lukewalker2010/mach1-rc-design/proposals/geometry/README.md

# Analytic geometry candidate — not manufacturing data

See [29](../../29_geometry_resolution.md) for formulas, source provenance,
numerical results, demonstrated packaging failures and unresolved interfaces.
`tools/geometry_candidates.py` is the candidate source; export functions can
produce review station CSVs. No generated net parts or qualified CAD are supplied.
Any future exports belong here and require review before promotion to baseline.
