lukewalker2010/mach1-rc-design/proposals/geometry/fuselage_stations_v3.csv

x_mm | R_mm | OD_mm
0 | 0.0 | 0.0
50 | 0.9226 | 1.8451
100 | 3.5396 | 7.0792
150 | 7.6252 | 15.2504
200 | 12.9534 | 25.9068
250 | 19.2983 | 38.5966
300 | 26.434 | 52.8679
350 | 34.1344 | 68.2689
400 | 42.1738 | 84.3476
450 | 50.3262 | 100.6524
500 | 58.3656 | 116.7311
550 | 66.066 | 132.1321
600 | 73.2017 | 146.4034
650 | 79.5466 | 159.0932
700 | 84.8748 | 169.7496
750 | 88.9604 | 177.9208
800 | 91.5774 | 183.1549
850 | 92.5 | 185.0
900 | 91.4844 | 182.9687
950 | 89.25 | 178.5
1000 | 87.0156 | 174.0312
1050 | 86.0 | 172.0
1100 | 86.3804 | 172.7607
1150 | 87.3561 | 174.7122
1200 | 88.6791 | 177.3582
1250 | 90.1014 | 180.2027
1300 | 91.3748 | 182.7495
1350 | 92.2513 | 184.5025
1400 | 92.5 | 185.0
1450 | 92.5 | 185.0
1500 | 92.5 | 185.0
1550 | 92.5 | 185.0
1600 | 92.5 | 185.0
1650 | 92.5 | 185.0
1700 | 92.5 | 185.0
1750 | 92.5 | 185.0
1800 | 92.5 | 185.0
1850 | 92.0789 | 184.1577
1900 | 90.8887 | 181.7773
1950 | 89.0393 | 178.0786
2000 | 86.6406 | 173.2812
2050 | 83.8025 | 167.605
2100 | 80.6348 | 161.2695
2150 | 77.2473 | 154.4946
2200 | 73.75 | 147.5
2250 | 70.2527 | 140.5054
2300 | 66.8652 | 133.7305
2350 | 63.6975 | 127.395
2400 | 60.8594 | 121.7188
2450 | 58.4607 | 116.9214
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
