lukewalker2010/mach1-rc-design/proposals/structure/wing_box_spar/stations.csv

station | y_m | chord_mm | moment_nm | shear_n | cap_thickness_mm | web_area_mm2 | web_shear_mpa | width_mm | cap_area_mm2 | separation_mm | outer_depth_mm | inner_height_mm | box_le_mm | box_te_mm | u_lo | u_hi
C0 | 0.0 | 210.52631578947373 | 150.0 | 736.8421052631566 | 1.0 | 7.830062067438473 | 94.104248333782 | 76.29656810450128 | 76.29656810450128 | 4.915031033719236 | 7.315031033719237 | 3.9150310337192367 | 67.11487384248622 | 143.4114419469875 | 0.3187956507518095 | 0.6812043492481905
R0 | 0.092625 | 185.89473684210532 | 90.88550624999995 | 543.5868421052621 | 0.883 | 7.084457140130598 | 76.72949830214392 | 58.14846144027421 | 51.34509145176213 | 4.4252285700653 | 6.708228570065299 | 3.542228570065299 | 63.87313770091555 | 122.02159914118977 | 0.34359841911591027 | 0.6564015808840897
R1 | 0.16902083333333334 | 165.5789473684211 | 54.859939728009174 | 402.2651315789467 | 0.7865 | 6.3684917830342425 | 63.1648976372376 | 43.916175567618026 | 34.54007208393158 | 3.9707458915171205 | 6.157245891517121 | 3.1842458915171212 | 60.831385900401536 | 104.74756146801957 | 0.3673859924054764 | 0.6326140075945236
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
