lukewalker2010/mach1-rc-design/09_bom.md

# Bill of Materials and Build Sequence

> **Historical:** the current aircraft allowance is `22_bom_v2.md`; this legacy
> BOM is retained for design history and is not a purchase list.

## 1. Bill of Materials

### 1.1 Major Components

| Item | Supplier / Part | Qty | Unit Cost | Total |
|---|---|-----|---|---|
| **Engine** | JetCat P550-PRO (incl. ECU + pump) | 1 | $4,500.00 | $4,500.00 |
| **Carbon fiber prepreg** | ACP Composites 3K twill 200 g/m² | 5 m² | $45.00/m² | $225.00 |
| **Carbon unidirectional (spar)** | DragonPlate 5 mm pultruded rod | 1 m | $18.00/m | $18.00 |
| **Epoxy resin (wet layup)** | West System 105 resin + 206 hardener | 2 L | $60.00/L | $120.00 |
| **Epoxy bonding / filleting** | West System 105 + 406 colloidal silica (flox) | 0.5 L | $40.00 | $40.00 |
| **Foam core (wing)** | Rohacell 71IG, 5 mm thick | 1 m² | $80.00/m² | $80.00 |
| **Inconel 718 (intake)** | Xometry DMLS (or similar additive mfg) | 1 | ~$350.00 | $350.00 |
| **304 stainless steel tube (nozzle)** | McMaster-Carr, 35 mm OD × 1 mm wall | 50 mm | $10.00 | $10.00 |
| **7075-T6 aluminum plate** | McMaster-Carr (mount ring, hardpoints) | 0.2 m² | $50.00 | $50.00 |
| **6061-T6 aluminum sheet** | McMaster-Carr (brackets, small parts) | 0.3 m² | $20.00 | $20.00 |

### 1.2 Avionics

| Item | Supplier / Part | Qty | Unit Cost | Total |
|---|---|-----|---|---|
| **RC receiver** | Futaba R7018SB (18-channel) | 1 | $350.00 | $350.00 |
| **Flight controller** | Cube Orange+ (Pixhawk) | 1 | $300.00 | $300.00 |
| **GPS module** | Here+ GNSS (or similar) | 1 | $100.00 | $100.00 |
| **Telemetry radio** | RFD900x (900 MHz) | 1 | $120.00 | $120.00 |
| **Pitot-static system** | Eagle Tree pitot + static ports | 1 | $45.00 | $45.00 |
| **Airspeed sensor** | MS4525DO differential pressure | 1 | $35.00 | $35.00 |

### 1.3 Power System

| Item | Supplier / Part | Qty | Unit Cost | Total |
|---|---|-----|---|---|
| **Battery** | 2S LiPo 5000 mAh 30C | 1 | $80.00 | $80.00 |
| **Power distribution board** | Custom PCB or Pre-built (Pixhawk Power Module) | 1 | $25.00 | $25.00 |
| **Connectors — Deans Ultra** | Amass T-plug (male + female pairs) | 3 | $4.00 | $12.00 |
| **Connectors — JR** | JR servo connectors (male + female) | 20 | $1.50 | $30.00 |
| **Wire — 14 AWG silicone** | Red/Black, per meter | 3 m | $5.00/m | $15.00 |
| **Wire — 20 AWG silicone** | Assorted colors, per meter | 5 m | $3.00/m | $15.00 |
| **Wire — 22 AWG silicone** | Signal wire, per meter | 10 m | $2.50/m | $25.00 |
| **Conduit — braided nylon** | 10 mm diameter | 3 m | $4.00/m | $12.00 |

### 1.4 Fuel System

| Item | Supplier / Part | Qty | Unit Cost | Total |
|---|---|-----|---|---|
| **Fuel bladder (custom)** | Polyurethane 2-ply, 1.5 L | 1 | $50.00 | $50.00 |
| **Viton tubing** | 4 mm ID × 7 mm OD | 3 m | $15.00/m | $45.00 |
| **Viton tubing (vent)** | 2 mm ID × 4 mm OD | 1 m | $10.00/m | $10.00 |
| **Fuel dot** | Dubro 6 mm (HD-175) | 1 | $8.00 | $8.00 |
| **Check valve** | One-way fuel vent valve | 1 | $12.00 | $12.00 |
| **Fuel filter** | Felt clunk filter (large) | 1 | $6.00 | $6.00 |
| **Brass fittings** | Assorted barbs, tees, elbows | 1 lot | $15.00 | $15.00 |

### 1.5 Control System

| Item | Supplier / Part | Qty | Unit Cost | Total |
|---|---|-----|---|---|
| **Servo — KST X20-12T** | High-voltage, 12 kg·cm titanium gear | 2 | $120.00 | $240.00 |
| **Pushrod** | 2 mm titanium rod, threaded ends | 2 | $5.00 | $10.00 |
| **Ball links** | Dubro 4-40 (or M2.5) with hardware | 4 | $4.00 | $16.00 |
| **Servo extension wires** | 300 mm JR-type | 4 | $4.00 | $16.00 |
| **Servo mounting screws** | M2.5 × 6 mm stainless | 8 | $0.50 | $4.00 |

### 1.6 Landing and Launch

| Item | Supplier / Part | Qty | Unit Cost | Total |
|---|---|-----|---|---|
| **UHMWPE strip** | 50 mm × 200 mm × 5 mm | 2 | $8.00 | $16.00 |
| **Titanium sheet (skid shoe)** | Ti-6Al-4V, 1 mm × 50 mm × 200 mm | 2 | $15.00 | $30.00 |
| **Dolly wheel — polyurethane** | 50 mm dia × 20 mm wide (custom) | 2 | $12.00 | $24.00 |
| **Dolly frame extrusion** | 2024-T6 T-slot, 20 × 20 mm | 2 m | $12.00/m | $24.00 |
| **Dolly hardware** | Axles, bearings, E-clips, fasteners | 1 lot | $15.00 | $15.00 |
| **Dolly latch servo** | 5 g micro servo (metal gear) | 1 | $12.00 | $12.00 |
| **Separation spring** | Compression, 50 N, 30 mm stroke | 1 | $5.00 | $5.00 |
| **Dolly parachute (optional)** | 0.3 m ripstop nylon | 1 | $10.00 | $10.00 |

### 1.7 Drogue Chute

| Item | Supplier / Part | Qty | Unit Cost | Total |
|---|---|-----|---|---|
| **Main chute** | 0.6 m hemispherical ribbon, ripstop nylon | 1 | $30.00 | $30.00 |
| **Pilot chute** | 0.1 m spring-loaded | 1 | $15.00 | $15.00 |
| **Bridle line** | 500 kg Kevlar, 3 m | 1 | $10.00 | $10.00 |
| **Swivel** | Ball-bearing swivel | 1 | $8.00 | $8.00 |
| **Container (G10 box)** | Custom fiberglass/ G10 | 1 | $20.00 | $20.00 |
| **Weak link / jettison** | Kevlar thread 100 kg + hook | 1 | $12.00 | $12.00 |

### 1.8 Tooling and Consumables

| Item | Supplier / Part | Qty | Unit Cost | Total |
|---|---|-----|---|---|
| **Mold release** | Partall #2 or similar | 1 L | $25.00 | $25.00 |
| **Peel ply** | Nylon peel ply (1 m wide) | 5 m | $8.00/m | $40.00 |
| **Breather fabric** | Polyester breather (1 m wide) | 5 m | $6.00/m | $30.00 |
| **Vacuum bag film** | Nylon bag film (1 m wide) | 5 m | $10.00/m | $50.00 |
| **Bag sealant tape** | QT-2 butyl sealant tape | 2 rolls | $6.00 | $12.00 |
| **CNC foam (plug)** | Polyurethane foam block, 200×200×1000mm | 1 | $30.00 | $30.00 |
| **Sanding supplies** | Grits 80–1000, sanding blocks | 1 lot | $25.00 | $25.00 |
| **Vacuum pump** | Robinair 2-stage (rental or shop) | 1 use | $50.00 | $50.00 |
| **CFC / tooling gelcoat** | Tooling gelcoat (grey) | 2 kg | $30.00/kg | $60.00 |
| **Fiberglass (tooling)** | 200 g/m² woven, for splash mold | 10 m² | $10.00/m² | $100.00 |
| **Fasteners assortment** | M2, M2.5, M3, M4, M6 nylon + stainless | 1 lot | $30.00 | $30.00 |

### 1.9 Summary

| Category | Cost |
|---|---|
| Major structure & engine | $5,413.00 |
| Avionics | $950.00 |
| Power system | $174.00 |
| Fuel system | $146.00 |
| Control system | $286.00 |
| Landing & launch | $136.00 |
| Drogue chute | $95.00 |
| Tooling & consumables | $462.00 |
| **Total** | **~$7,662.00** |

> **Note:** Rounding to **~$7,000–7,700** depending on discounts / sourcing. Prices as of 2026.

---

## 2. Build Sequence

### Phase 1 — Tooling (40 hours estimated)

| Step | Task | Hours | Details |
|---|---|---|---|
| 1.1 | CNC mill fuselage plug from station table | 20 | PU foam block machined to fuselage station templates, sanded smooth |
| 1.2 | Splash mold from plug | 15 | Apply tooling gelcoat, 10 layers 200 g/m² fiberglass, cure, separate |
| 1.3 | CNC mill wing mold (female) | 5 | Two-cavity mold for upper and lower wing skins |
| **Phase 1 total** | | **40** | |

### Phase 2 — Structure (60 hours estimated)

| Step | Task | Hours | Details |
|---|---|---|---|
| 2.1 | Lay up fuselage halves | 10 | Hand layup of prepreg carbon in mold, vacuum bag, oven cure (120°C) |
| 2.2 | Trim and bond fuselage halves | 4 | Diamond cut off wheel, structural epoxy + 50 mm carbon doubler strips |
| 2.3 | Install bulkheads BH1–BH8 | 8 | Precision locate from station table, bond with flox structural fillets |
| 2.4 | Fabricate wing skins | 6 | Layup in mold, 4 layers 200 g/m² prepreg, vacuum bag, cure |
| 2.5 | Machine wing spar groove in foam core | 4 | CNC router pocket for 5 mm carbon rod, test fit |
| 2.6 | Insert spar + assemble wing | 2 | Bond carbon rod with structural epoxy, fit to foam core |
| 2.7 | Wing skin bonding | 8 | Bond upper and lower skins to foam core + spar, vacuum bag, cure |
| 2.8 | Trim wing to final shape | 2 | Diamond wheel, profile to airfoil template |
| 2.9 | Fabricate stabilator | 4 | Solid carbon laminate layup, cure, profile to NACA 64A-xxx, |
| 2.10 | Bond waist doubler + hardpoints | 4 | Internal doubler strips at wing root, M4 threaded inserts |
| 2.11 | Install engine mount ring and legs | 4 | 7075-T6 ring bonded to BH5/BH6, 3 legs with screws to engine |
| 2.12 | Bond belly skid brackets | 2 | 2 mm Al brackets to fuselage hardpoints |
| 2.13 | Install drogue chute container | 2 | G10 box bonded into tailcone, door hinged and fit-checked |
| **Phase 2 total** | | **60** | |

### Phase 3 — Systems Installation (30 hours estimated)

| Step | Task | Hours | Details |
|---|---|---|---|
| 3.1 | Install fuel bladder + plumbing | 4 | Position bladder in forward bay, route Viton lines, install clunk and fittings |
| 3.2 | Install vent line + check valve | 1 | Route 2 mm line from tank to bottom of fuselage |
| 3.3 | Install fuel dot (filler) | 0.5 | Flush mount on fuselage side at x = 0.50 m |
| 3.4 | Install servos + pushrods | 4 | Mount KST X20-12T in wing (elevon?), 2 mm Ti pushrods, ball links |
| 3.5 | Install avionics tray + flight controller | 4 | TPU vibration mount, Cube Orange, receiver, secure with nylon screws |
| 3.6 | Install GPS + pitot-static system | 2 | GPS on fuselage top, pitot probe on nose, static ports on sides |
| 3.7 | Install telemetry module + antenna | 1 | RFD900x in dorsal fairing, whip antenna |
| 3.8 | Run wiring + install connectors | 8 | Shielded conduits along fuse sides, power starboard, signal port, continuity test |
| 3.9 | Install engine + intake + nozzle | 4 | Mount P550-PRO on ring, fit intake duct, nozzle, secure ECU |
| 3.10 | CG check + ballast adjustment | 2 | Weigh aircraft at 3 points, compare to CG table, add tungsten ballast as needed |
| 3.11 | Install drogue chute system | 2 | Pack main + pilot chute, install bridle + weak link, test door servo |
| 3.12 | Install belly skid strips | 1 | Bolt UHMWPE strips to Ti shoes, bolt shoes to brackets |
| 3.13 | Final systems integration test | 2 | Power on, servo range check, FC calibration, ECU communication |
| **Phase 3 total** | | **30** | |

### Phase 4 — Testing and Flight (20 hours estimated)

| Step | Task | Hours | Details |
|---|---|---|---|
| 4.1 | Engine ground run with intake | 2 | Secure aircraft, run engine to idle, check EGT/TIT, spool to full, verify stable |
| 4.2 | Range check + failsafe setup | 2 | Walk 100 m with transmitter, failsafe: throttle idle, full-up elevon |
| 4.3 | Control surface check | 1 | Full deflection measure, direction verify, rate check |
| 4.4 | High-speed taxi test on dolly | 2 | Attach dolly, taxi to 30 m/s, verify tracking, steering, dolly retention |
| 4.5 | Flight 1 — Low-speed handling (M0.2) | 3 | Launch, trim at ~70 m/s, basic handling, land with drogue |
| 4.6 | Flight 2 — Envelope expansion (M0.5) | 3 | Increase speed to ~170 m/s, check stability, pitch response |
| 4.7 | Flight 3 — High-speed check (M0.7) | 3 | ~240 m/s, verify controls at high dynamic pressure |
| 4.8 | Flight 4 — Transonic attempt (M0.9→M1+) | 4 | Full throttle run, Mach target 0.95–1.05, record with GPS + Doppler |
| **Phase 4 total** | | **20** | |

### Build Timeline Summary

| Phase | Hours | % of Total |
|---|---|---|
| Phase 1 — Tooling | 40 | 27% |
| Phase 2 — Structure | 60 | 40% |
| Phase 3 — Systems | 30 | 20% |
| Phase 4 — Testing | 20 | 13% |
| **Total** | **150** | **100%** |

---

## 3. Safety Equipment Checklist

- [ ] **Fire extinguisher** — CO₂, 5 lb, at flight line (within 10 m of pit area)
- [ ] **Nomex flight gloves** — Required for engine starting and handling hot sections
- [ ] **Hearing protection** — 30+ dB NRR ear muffs (turbine = 120+ dB at close range)
- [ ] **Eye protection** — Safety glasses (impact rated, Z87+)
- [ ] **First aid kit** — At pit area
- [ ] **Fuel container** — Approved, grounded Jet-A1 container with spout
- [ ] **Fuel spill kit** — Absorbent pads, gloves, disposal bag
- [ ] **Fire blanket** — For engine fire containment
- [ ] **Grounding strap** — For fueling operation (static discharge prevention)
- [ ] **FAA COA or restricted airspace clearance** — Required for any high-speed / record flight
- [ ] **Insurance** — AMA membership + supplemental turbine waiver insurance
- [ ] **Doppler radar** — For speed verification (or certified GPS-logger for record)

---

## 4. Flight Day Checklist

### 4.1 Pre-Flight (2 hours prior)
- [ ] Weather check: wind < 10 kt, visibility > 5 km, no precipitation
- [ ] Airspace clearance confirmed (COA active, NOTAM issued if required)
- [ ] Flight area marked and spectator exclusion zone set (min 100 m radius)
- [ ] All safety equipment on-site (fire extinguisher, first aid, Nomex gloves)

### 4.2 Aircraft Preparation (1 hour prior)
- [ ] **Structural inspection:** All bond lines (fuselage seam, wing root, stabilator), no cracks or delamination
- [ ] **Fastener check:** All screws and bolts present and tight (M2 through M4)
- [ ] **Control surface:** Full deflection check — elevons, rudder if present — direction and range
- [ ] **Pushrod / ball link:** No slop, secure clevis retainers
- [ ] **Fuel system:** Tank full (1.5 L Jet A-1), no leaks, clunk free, vent clear
- [ ] **Battery:** 2S LiPo at storage voltage (7.6–7.8 V), charge if needed to 8.2 V
- [ ] **Telemetry / GPS:** Power on, satellite lock (min 10 sats), HDOP < 1.0
- [ ] **Receiver range check:** Reduced power mode, 100 m walk, no frame loss

### 4.3 Engine Start (30 min prior)
- [ ] **Fire extinguisher** positioned near tail, operator wearing Nomex gloves
- [ ] **ECU startup:** Connect ECU to computer (JetCat USB), verify firmware, parameters
- [ ] **Fuel prime:** Prime fuel line (pump in manual mode until fuel reaches engine)
- [ ] **Start:** Command start, monitor EGT/TIT (max 850°C on start)
- [ ] **Idle check:** 2 min at idle (60,000 RPM typical), verify stable EGT
- [ ] **Full-throttle run (5 s):** Spool to full (165,000 RPM), verify RPM, EGT, fuel flow
- [ ] **Return to idle:** Check idle stability after full-throttle

### 4.4 Launch Preparation (15 min prior)
- [ ] **Dolly attachment:** Place dolly under fuselage, engage latch pins, verify positive lock
- [ ] **Dolly release test:** On ground, cycle release servo, confirm clean separation
- [ ] **Drogue chute armed:** Door servo connected, safeties removed
- [ ] **Flight path clear:** Visual scan of airspace, observers in position
- [ ] **Go/no-go decision:** Wind, visibility, aircraft readiness, pilot readiness
- [ ] **Final control check:** Full deflection observed from behind aircraft

### 4.5 Launch Sequence
1. **Pilot:** "Cleared for takeoff" — advance throttle to full
2. Acceleration monitored by telemetry (GPS groundspeed)
3. At V_r ≈ 70 m/s (or positive pitch command from FC)
4. Dolly latch release (pitch-up detected by FC or Rx switch)
5. Clean separation confirmed visually
6. **Pilot:** "Positive rate, gear up" (dolly released)
7. Climb at 70 m/s to safe altitude (100 m AGL minimum)

### 4.6 In-Flight
- [ ] Trim aircraft at cruise speed (M0.2 for first flights)
- [ ] Monitor EGT, RPM, fuel level via telemetry
- [ ] Note any handling quirks (pitch sensitivity, roll rate, coupling)

### 4.7 Landing
- [ ] Throttle to idle, deploy drogue chute (if >15 m/s final)
- [ ] Belly skid contact, hold attitude until stop
- [ ] **Post-landing:** Engine shutdown (ECU spool-down cycle)
- [ ] Fuel remaining measurement, CG check for excursion data

### 4.8 Post-Flight
- [ ] Skid wear inspection, replace strips if worn below 2 mm
- [ ] Drogue chute repack (if deployed)
- [ ] Dolly inspection (if recovered), repair any damage
- [ ] Data download: GPS track, FC logs, ECU data
- [ ] Battery recharge (LiPo storage voltage)
- [ ] Debrief: handling notes, adjustments for next flight
