lukewalker2010/mach1-rc-design/09_bom_with_links.md

# Mach 1 RC Aircraft — Complete Bill of Materials with Purchase Links

> **Historical (2026-07-21):** retained for source/link history. The current
> aircraft allowance is `22_bom_v2.md`; flagged parts there remain
> unpurchase-qualified.

**Updated:** 2026-07-21
**Total Budget:** ~$7,700

---

## 1. Engine & Powerplant

| Item | Part | Qty | Price | Purchase Link | Notes |
|---|---|-----|---|---|---|
| **Engine** | JetCat P550-PRO (incl. ECU + pump) | 1 | $4,500 | [jetcat.de](https://www.jetcat.de/en/products/produkte/jetcat/kategorien/professional/550%20PRO-S) · [Chief RC](https://www.chiefrc.com/collections/jet-cat-turbines) | Price on request from JetCat. US dealers ~$4,500-5,500 |

## 2. Major Structure Materials

| Item | Part | Qty | Price | Purchase Link | Notes |
|---|---|-----|---|---|---|
| **Carbon prepreg** | ACP Composites 3K twill 200 g/m² | 5 m² | $225 | [ACP Composites — Carbon Prepregs](https://acpcomposites.com/category/carbon-fiber/carbon-prepregs) | |
| **Carbon spar rod** | DragonPlate 5mm pultruded T800 | 1m | $18 | [DragonPlate — Carbon Fiber Rods](https://dragonplate.com/carbon-fiber-rod) | |
| **Epoxy resin** | West System 105 + 206 hardener | 2L | $120 | [West System](https://www.westsystem.com) · [Amazon](https://www.amazon.com/s?k=west+system+105+206) | |
| **Epoxy bonding** | West System 105 + 406 colloidal silica | 0.5L | $40 | [West System](https://www.westsystem.com) | |
| **Foam core** | Rohacell 71IG, 5mm | 1 m² | $80 | [Aircraft Spruce](https://www.aircraftspruce.com) | |
| **Inconel 718 intake** | Xometry DMLS 3D print | 1 | $350 | [Xometry — Instant Quote](https://www.xometry.com) | Upload STL, get instant quote |
| **SS tube (nozzle)** | 304 SS, 35mm OD × 1mm wall | 50mm | $10 | [mcmaster.com](https://www.mcmaster.com/304-stainless-steel-tubing) | P/N 89525K514 |
| **7075-T6 plate** | Mount ring, hardpoints | 0.2m² | $50 | [mcmaster.com](https://www.mcmaster.com/7075-aluminum) | |
| **6061-T6 sheet** | Brackets, small parts | 0.3m² | $20 | [mcmaster.com](https://www.mcmaster.com/6061-aluminum) | |

## 3. Avionics

| Item | Part | Qty | Price | Purchase Link | Notes |
|---|---|-----|---|---|---|
| **RC Receiver** | Futaba R7018SB (18-ch FASSTest) | 1 | $329 | [eBay](https://www.ebay.com/sch/i.html?_nkw=Futaba+R7018SB) · [HobbyKing](https://hobbyking.com/en_us/futaba-r7018sb-s-bus-2-18ch-fasstest-telemetry-receiver.html) · [Modelland](https://store.modelland.com/p-110546-futaba-futr7018sb-r7018sb-2-4ghz-fasstest-receiver-dual-battery.aspx) | Check stock — often sold out |
| **Flight Controller** | Cube Orange+ Standard Set (w/ ADS-B) | 1 | $300 | [Amazon](https://www.amazon.com/The-Cube-Orange-Standard-Set/dp/B0C8Y1LMGZ) · [ReadyMadeRC](https://www.readymaderc.com/products/details/pixhawk2-cube-orange-plus-standard-set-cube-carrier) · [CubePilot](https://www.cubepilot.com) | |
| **GPS** | CubePilot Here+ RTK GNSS (M8P) | 1 | $100 | [CubePilot](https://www.cubepilot.com) · [GetFPV](https://www.getfpv.com/cubepilot-here-rtk-gnss-gps-kit-m8p.html) · [RobotShop](https://www.robotshop.com/products/cubepilot-here-v2-rtk-gnss-gps-m8p) | |
| **Telemetry** | RFD900x-US (FCC approved) | 1 | $120 | [ReadyMadeRC](https://www.readymaderc.com/products/details/rfdesign-rfd-900x-modem-us-fcc) · [RFD900x Bundle](https://www.readymaderc.com/products/details/rfdesign-900x-telemetry-modem-bundle) · [WorldDroneMarket](https://www.worldronemarket.com/product/rfd900x-us-bundle/) | Buy bundle (air + ground) for ~$220 |
| **Pitot-static** | Eagle Tree pitot + static ports | 1 | $45 | [ReadyMadeRC — Eagle Tree Pitot Kit](https://www.readymaderc.com/products/details/eagle-tree-additional-prandtl-pitot-static-tube-kit) | |
| **Airspeed sensor** | MS4525DO differential pressure | 1 | $35 | [Mouser](https://www.mouser.com/Search/Refine?Keyword=MS4525DO) · [DigiKey](https://www.digikey.com/en/products/filter/pressure-sensors/534) · [eBay](https://www.ebay.com/sch/i.html?_nkw=MS4525DO) | |

## 4. Power System

| Item | Part | Qty | Price | Purchase Link | Notes |
|---|---|-----|---|---|---|
| **Battery** | 2S LiPo 5000mAh 30C | 1 | $80 | [Amazon](https://www.amazon.com/s?k=2S+LiPo+5000mAh+30C) · [HobbyKing](https://hobbyking.com) · [AMain Hobbies](https://www.amainhobbies.com) | Deans connector preferred |
| **Power dist** | Pixhawk Power Module | 1 | $25 | [CubePilot](https://www.cubepilot.com) · [Amazon](https://www.amazon.com/s?k=pixhawk+power+module) | |
| **Deans connectors** | Amass T-plug pairs | 3 | $12 | [Amazon](https://www.amazon.com/s?k=amass+deans+t-plug) | |
| **JR connectors** | Male + female servo connectors | 20 | $30 | [Amazon](https://www.amazon.com/s?k=jr+servo+connector) | |
| **Wire 14AWG** | Silicone, red/black | 3m | $15 | [Amazon](https://www.amazon.com/s?k=14+awg+silicone+wire) | |
| **Wire 20AWG** | Silicone, assorted | 5m | $15 | [Amazon](https://www.amazon.com/s?k=20+awg+silicone+wire) | |
| **Wire 22AWG** | Silicone, signal | 10m | $25 | [Amazon](https://www.amazon.com/s?k=22+awg+silicone+wire) | |
| **Conduit** | Braided nylon, 10mm | 3m | $12 | [Amazon](https://www.amazon.com/s?k=braided+nylon+cable+sleeve+10mm) | |

## 5. Fuel System

| Item | Part | Qty | Price | Purchase Link | Notes |
|---|---|-----|---|---|---|
| **Fuel bladder** | Polyurethane 2-ply, 1.5L custom | 1 | $50 | Custom — [McMaster](https://www.mcmaster.com) polyurethane sheet | Or contact JetCat for OEM tank |
| **Viton tubing** | 4mm ID × 7mm OD | 3m | $45 | [McMaster](https://www.mcmaster.com/viton-tubing) · [Amazon](https://www.amazon.com/s?k=viton+tubing+4mm) | |
| **Viton vent** | 2mm ID × 4mm OD | 1m | $10 | [McMaster](https://www.mcmaster.com) | |
| **Fuel dot** | Dubro HD-175 (6mm) | 1 | $8 | [Amazon](https://www.amazon.com/s?k=dubro+fuel+dot) · [Tower Hobbies](https://www.towerhobbies.com) | |
| **Check valve** | One-way fuel vent | 1 | $12 | [Amazon](https://www.amazon.com/s?k=fuel+check+valve+rc) | |
| **Clunk filter** | Felt filter, large | 1 | $6 | [Amazon](https://www.amazon.com/s?k=rc+fuel+clunk+filter) | |
| **Brass fittings** | Barbs, tees, elbows | 1 lot | $15 | [Amazon](https://www.amazon.com/s?k=brass+barb+fittings+rc) | |

## 6. Control System

| Item | Part | Qty | Price | Purchase Link | Notes |
|---|---|-----|---|---|---|
| **Servos** | KST X20-12T (12kg HV titanium) | 2 | $240 | [KST Official](https://kstservos.com/collections/x20-series-1) ($120ea) · [Buddy RC](https://www.buddyrc.com/collections/kst-servos) · [eBay](https://www.ebay.com/sch/i.html?_nkw=KST+X20-12T) | Check stock — popular servo |
| **Pushrods** | 2mm Ti rod, threaded ends | 2 | $10 | [Amazon](https://www.amazon.com/s?k=2mm+titanium+rod+threaded) | |
| **Ball links** | Dubro 4-40 / M2.5 | 4 | $16 | [Amazon](https://www.amazon.com/s?k=dubro+ball+link) | |
| **Servo extensions** | 300mm JR-type | 4 | $16 | [Amazon](https://www.amazon.com/s?k=servo+extension+300mm+jr) | |
| **Servo screws** | M2.5 × 6mm stainless | 8 | $4 | [Amazon](https://www.amazon.com/s?k=M2.5+stainless+screws) | |

## 7. Landing & Launch

| Item | Part | Qty | Price | Purchase Link | Notes |
|---|---|-----|---|---|---|
| **UHMWPE strip** | 50mm × 200mm × 5mm | 2 | $16 | [Amazon](https://www.amazon.com/s?k=uhmwpe+sheet) · [McMaster](https://www.mcmaster.com/uhmw) | |
| **Ti skid shoe** | Ti-6Al-4V, 1mm × 50mm × 200mm | 2 | $30 | [eBay](https://www.ebay.com/sch/i.html?_nkw=titanium+sheet+6al4v) | |
| **Dolly wheels** | 50mm PU, 20mm wide | 2 | $24 | [Amazon](https://www.amazon.com/s?k=50mm+polyurethane+wheel) | |
| **Dolly frame** | 2024-T6 T-slot 20×20mm | 2m | $24 | [McMaster](https://www.mcmaster.com/t-slot-framing) | |
| **Dolly hardware** | Axles, bearings, E-clips | 1 lot | $15 | [Amazon](https://www.amazon.com/s?k=mini+bearing+axle+kit) | |
| **Release servo** | 5g micro servo, metal gear | 1 | $12 | [Amazon](https://www.amazon.com/s?k=5g+micro+servo+metal+gear) | |
| **Separation spring** | 50N compression, 30mm stroke | 1 | $5 | [McMaster](https://www.mcmaster.com/springs) | |
| **Dolly parachute** | 0.3m ripstop nylon | 1 | $10 | [Amazon](https://www.amazon.com/s?k=ripstop+nylon+mini+parachute) | |

## 8. Drogue Chute

| Item | Part | Qty | Price | Purchase Link | Notes |
|---|---|-----|---|---|---|
| **Main chute** | 0.6m hemispherical ribbon | 1 | $30 | [ChutingStar](https://www.chutingstar.com) · [Amazon](https://www.amazon.com/s?k=0.6m+drogue+parachute) | |
| **Pilot chute** | 0.1m spring-loaded | 1 | $15 | [Amazon](https://www.amazon.com/s?k=rc+pilot+chute+spring) | |
| **Bridle** | 500kg Kevlar, 3m | 1 | $10 | [Amazon](https://www.amazon.com/s?k=kevlar+cord+500kg) | |
| **Swivel** | Ball-bearing swivel | 1 | $8 | [Amazon](https://www.amazon.com/s?k=ball+bearing+swivel+parachute) | |
| **Container** | G10 box, custom | 1 | $20 | Fabricate from G10 sheet | |
| **Weak link** | Kevlar thread 100kg + hook | 1 | $12 | [Amazon](https://www.amazon.com/s?k=kevlar+thread+parachute) | |

## 9. Tooling & Consumables

| Item | Part | Qty | Price | Purchase Link | Notes |
|---|---|-----|---|---|---|
| **Mold release** | Partall #2 paste wax | 1L | $25 | [Amazon](https://www.amazon.com/s?k=partall+2+mold+release) | |
| **Peel ply** | Nylon, 1m wide | 5m | $40 | [Amazon](https://www.amazon.com/s?k=peel+ply+nylon+composite) | |
| **Breather cloth** | Polyester, 1m wide | 5m | $30 | [Amazon](https://www.amazon.com/s?k=vacuum+bagging+breather+cloth) | |
| **Vacuum bag** | Nylon film, 1m wide | 5m | $50 | [Amazon](https://www.amazon.com/s?k=vacuum+bag+film+nylon) | |
| **Bag sealant** | QT-2 butyl tape | 2 rolls | $12 | [Amazon](https://www.amazon.com/s?k=vacuum+bag+sealant+tape) | |
| **CNC foam plug** | PU foam block 200×200×1000mm | 1 | $30 | [McMaster](https://www.mcmaster.com/urethane-foam) | |
| **Sanding** | Grits 80-1000, blocks | 1 lot | $25 | [Amazon](https://www.amazon.com/s?k=sandpaper+assortment+80+1000) | |
| **Tooling gelcoat** | Grey, 2kg | 2kg | $60 | [Fibre Glast](https://www.fibreglast.com) · [Amazon](https://www.amazon.com/s?k=tooling+gelcoat) | |
| **Fiberglass** | 200 g/m² woven, tooling | 10 m² | $100 | [Fibre Glast](https://www.fibreglast.com) · [Amazon](https://www.amazon.com/s?k=fiberglass+cloth+200g) | |
| **Fasteners** | M2-M6 nylon + stainless | 1 lot | $30 | [Amazon](https://www.amazon.com/s?k=model+aircraft+hardware+kit) | |

---

## Budget Summary

| Category | Estimated Cost |
|---|---|
| Engine & powerplant | $4,500 |
| Structure materials | $923 |
| Avionics | $929 |
| Power system | $224 |
| Fuel system | $146 |
| Control system | $286 |
| Landing & launch | $136 |
| Drogue chute | $95 |
| Tooling & consumables | $427 |
| **Total** | **~$7,666** |

---

## Quick Buy Checklist

### Priority 1 — Order Now (long lead times)
- [ ] JetCat P550-PRO — contact [jetcat.de](https://www.jetcat.de) or [Chief RC](https://www.chiefrc.com) for quote
- [ ] Futaba R7018SB — check [eBay](https://www.ebay.com/sch/i.html?_nkw=Futaba+R7018SB)
- [ ] KST X20-12T ×2 — order from [kstservos.com](https://kstservos.com)
- [ ] Inconel 718 DMLS — upload STL to [Xometry](https://www.xometry.com)

### Priority 2 — Order This Week
- [ ] Cube Orange+ — [Amazon](https://www.amazon.com/dp/B0C8Y1LMGZ) or [ReadyMadeRC](https://www.readymaderc.com/products/details/pixhawk2-cube-orange-plus-standard-set-cube-carrier)
- [ ] RFD900x bundle — [ReadyMadeRC](https://www.readymaderc.com/products/details/rfdesign-900x-telemetry-modem-bundle)
- [ ] Here+ GPS — [CubePilot](https://www.cubepilot.com)
- [ ] Carbon prepreg — [ACP Composites](https://acpcomposites.com/category/carbon-fiber/carbon-prepregs)
- [ ] DragonPlate spar rod — [DragonPlate](https://dragonplate.com/carbon-fiber-rod)

### Priority 3 — Order When Ready to Build
- [ ] All Amazon consumables (wire, connectors, epoxy, vacuum supplies)
- [ ] McMaster items (tubing, aluminum, foam, springs)
- [ ] Fuel system components
- [ ] Landing gear hardware

---

*Prices verified July 2026. Verify availability before ordering — some items go out of stock frequently.*
