lukewalker2010/mach1-rc-design/ab_assembly.step

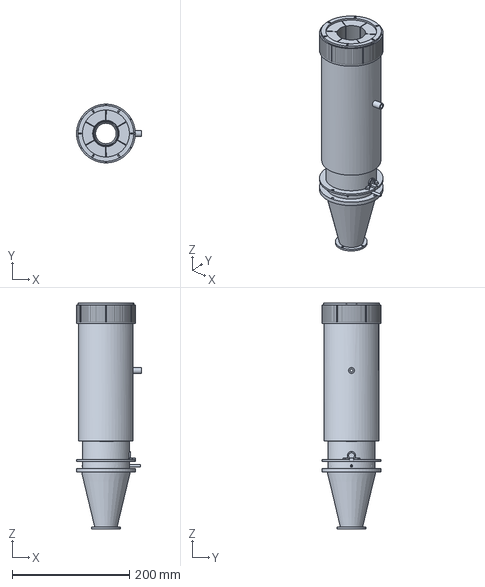
[picture p1: CAD file, 2026-11-08]
ab_assembly.step
110.5 x 100.0 x 385.0 mm
