lukewalker2010/mach1-rc-design/ab_liner.step

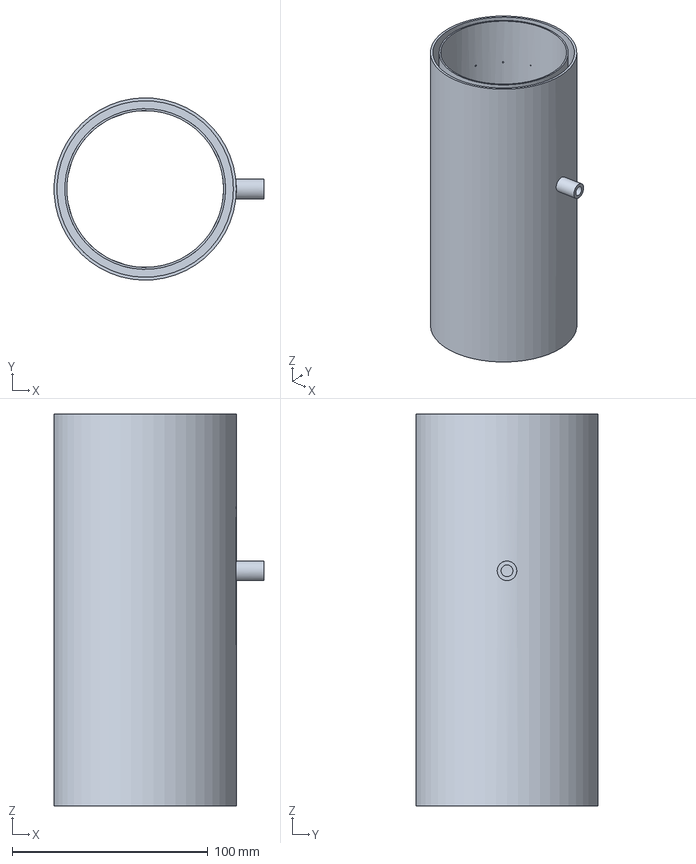
[picture p2: CAD file, 2026-11-08]
ab_liner.step
106.9 x 93.0 x 200.0 mm
