lukewalker2010/mach1-rc-design/proposals/structure/wing_box_spar/rib_R1_front.dxf

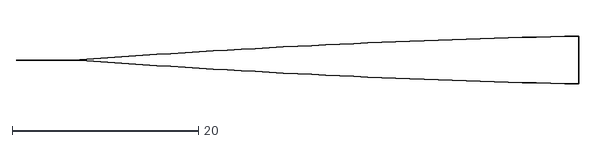
[picture p3: CAD file, 2026-11-10]
proposals/structure/wing_box_spar/rib_R1_front.dxf
60.3 x 5.14
