lukewalker2010/mach1-rc-design/wing_manufacturing/dxf/wing_rib_R2.dxf

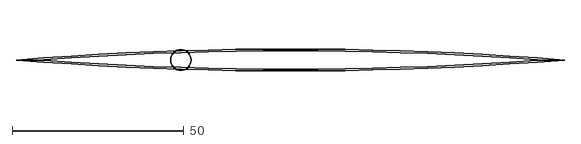
[picture p4: CAD file, 2026-08-07]
wing_manufacturing/dxf/wing_rib_R2.dxf
159.6 x 6.38
