lukewalker2010/mach1-rc-design/proposals/structure/wing_box_spar/rib_R0_front.dxf

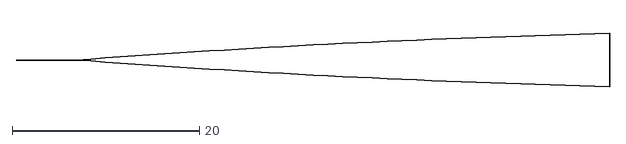
[picture p5: CAD file, 2026-11-10]
proposals/structure/wing_box_spar/rib_R0_front.dxf
63.4 x 5.68
