lukewalker2010/mach1-rc-design/wing_manufacturing/dxf/STA_TIP.dxf

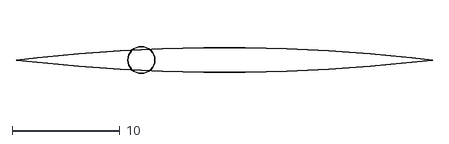
[picture p6: CAD file, 2026-08-07]
wing_manufacturing/dxf/STA_TIP.dxf
38.6 x 2.50
