lukewalker2010/mach1-rc-design/ab_iris_nozzle.step

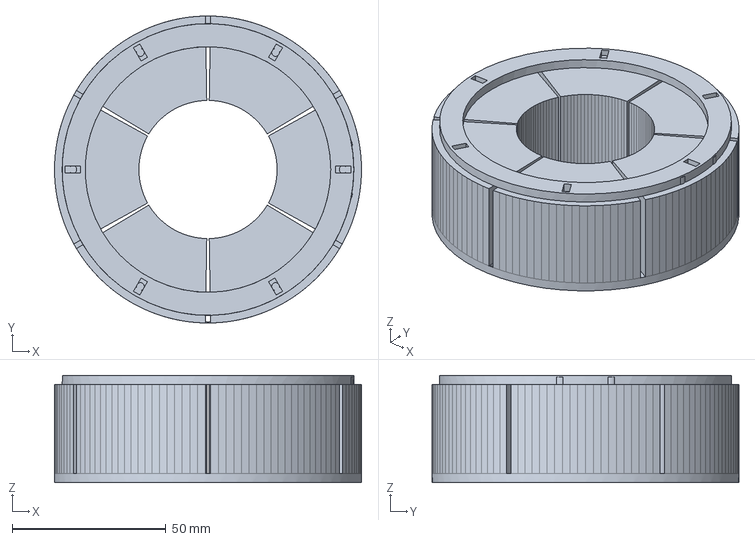
[picture p7: CAD file, 2026-11-08]
ab_iris_nozzle.step
100.0 x 100.0 x 35.0 mm
