lukewalker2010/mach1-rc-design/proposals/structure/wing_box_spar/rib_R0_rear.dxf

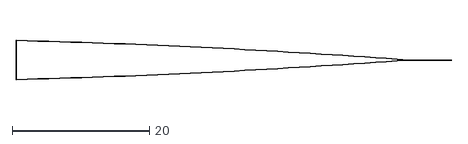
[picture p8: CAD file, 2026-11-10]
proposals/structure/wing_box_spar/rib_R0_rear.dxf
63.4 x 5.68
