lukewalker2010/mach1-rc-design/wing_manufacturing/dxf/wing_rib_R1.dxf

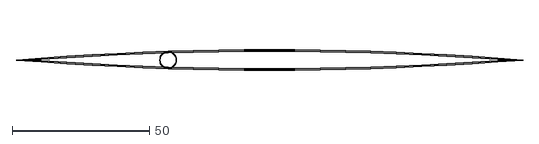
[picture p9: CAD file, 2026-08-07]
wing_manufacturing/dxf/wing_rib_R1.dxf
184.8 x 7.39
