lukewalker2010/mach1-rc-design/ab_spray_ring.step

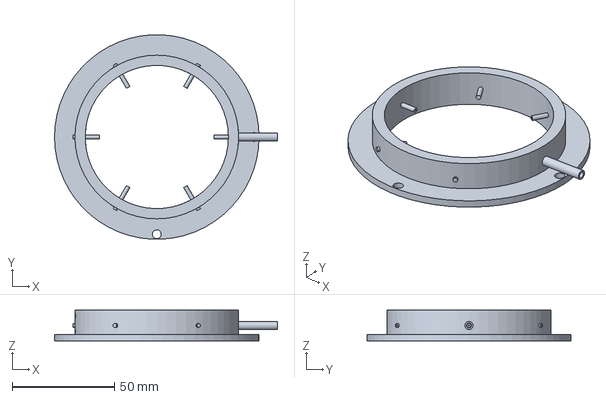
[picture p10: CAD file, 2026-11-08]
ab_spray_ring.step
109.0 x 99.9 x 15.0 mm
