lukewalker2010/mach1-rc-design/proposals/structure/wing_box_spar/rib_R3_front.dxf

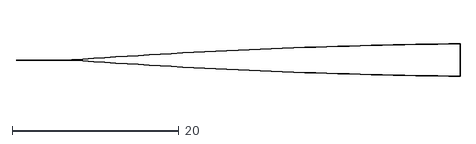
[picture p11: CAD file, 2026-11-10]
proposals/structure/wing_box_spar/rib_R3_front.dxf
53.2 x 3.89
