lukewalker2010/mach1-rc-design/wing_manufacturing/dxf/wing_rib_R5.dxf

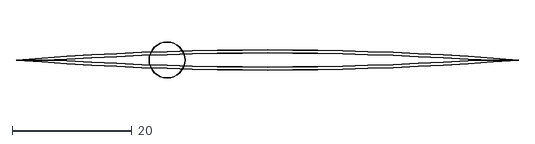
[picture p12: CAD file, 2026-08-07]
wing_manufacturing/dxf/wing_rib_R5.dxf
84.0 x 6.00
