lukewalker2010/mach1-rc-design/ab_transition.step

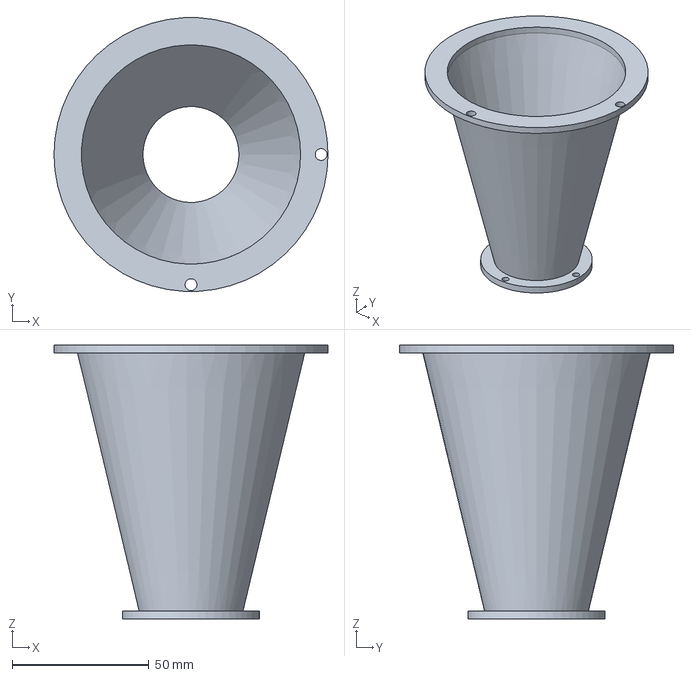
[picture p13: CAD file, 2026-11-08]
ab_transition.step
100.0 x 99.8 x 100.0 mm
