lukewalker2010/mach1-rc-design/proposals/structure/wing_box_spar/rib_R2_front.dxf

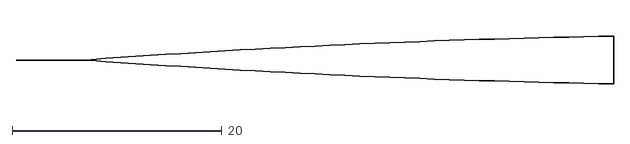
[picture p14: CAD file, 2026-11-10]
proposals/structure/wing_box_spar/rib_R2_front.dxf
57.0 x 4.54
