lukewalker2010/mach1-rc-design/wing_manufacturing/dxf/wing_rib_R4.dxf

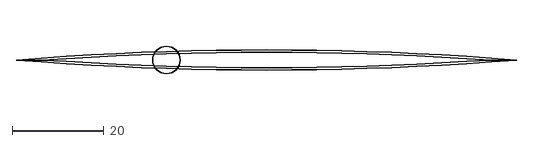
[picture p15: CAD file, 2026-08-07]
wing_manufacturing/dxf/wing_rib_R4.dxf
109.2 x 6.00
