lukewalker2010/mach1-rc-design/ab_flameholder.step

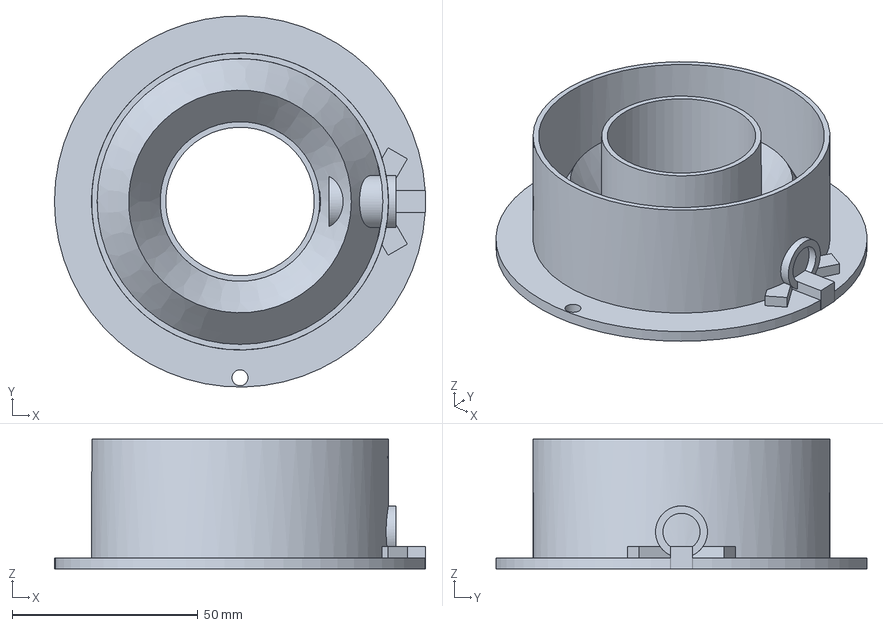
[picture p16: CAD file, 2026-11-08]
ab_flameholder.step
100.0 x 100.0 x 35.0 mm
