lukewalker2010/mach1-rc-design/wing_manufacturing/dxf/wing_rib_R0.dxf

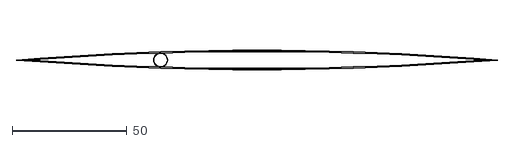
[picture p18: CAD file, 2026-08-07]
wing_manufacturing/dxf/wing_rib_R0.dxf
210.0 x 8.40
