lukewalker2010/mach1-rc-design/proposals/structure/wing_box_spar/rib_R5_rear.dxf

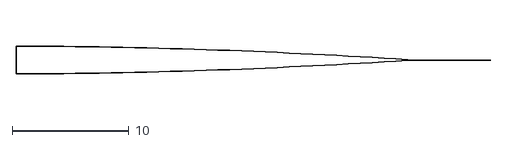
[picture p19: CAD file, 2026-11-10]
proposals/structure/wing_box_spar/rib_R5_rear.dxf
40.6 x 2.36
