lukewalker2010/mach1-rc-design/wing_manufacturing/dxf/STA_ROOT.dxf

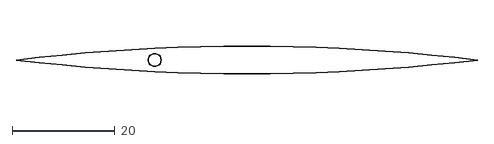
[picture p20: CAD file, 2026-08-07]
wing_manufacturing/dxf/STA_ROOT.dxf
90.0 x 5.40
