lukewalker2010/mach1-rc-design/proposals/structure/wing_box_spar/rib_C0_rear.dxf

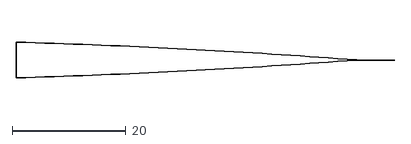
[picture p21: CAD file, 2026-11-10]
proposals/structure/wing_box_spar/rib_C0_rear.dxf
66.6 x 6.29
