lukewalker2010/mach1-rc-design/wing_manufacturing/dxf/STA_MID.dxf

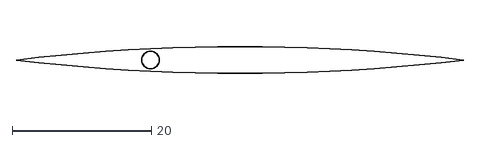
[picture p22: CAD file, 2026-08-07]
wing_manufacturing/dxf/STA_MID.dxf
64.3 x 3.86
