lukewalker2010/mach1-rc-design/proposals/structure/wing_box_spar/rib_R1_rear.dxf

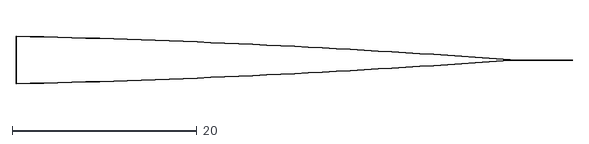
[picture p23: CAD file, 2026-11-10]
proposals/structure/wing_box_spar/rib_R1_rear.dxf
60.3 x 5.14
