lukewalker2010/mach1-rc-design/wing_manufacturing/dxf/wing_rib_R3.dxf

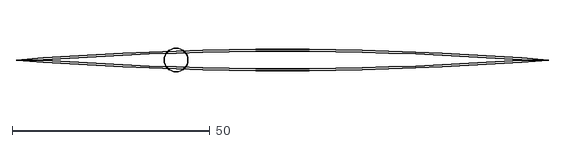
[picture p24: CAD file, 2026-08-07]
wing_manufacturing/dxf/wing_rib_R3.dxf
134.4 x 6.00
