lukewalker2010/mach1-rc-design/proposals/structure/wing_box_spar/rib_R2_rear.dxf

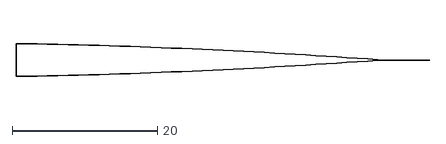
[picture p25: CAD file, 2026-11-10]
proposals/structure/wing_box_spar/rib_R2_rear.dxf
57.0 x 4.54
