lukewalker2010/mach1-rc-design/proposals/structure/wing_box_spar/rib_R4_front.dxf

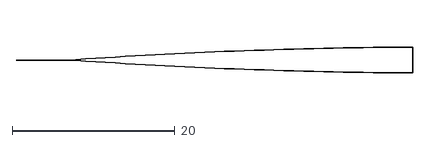
[picture p27: CAD file, 2026-11-10]
proposals/structure/wing_box_spar/rib_R4_front.dxf
48.7 x 3.16
