lukewalker2010/mach1-rc-design/proposals/structure/wing_box_spar/rib_R3_rear.dxf

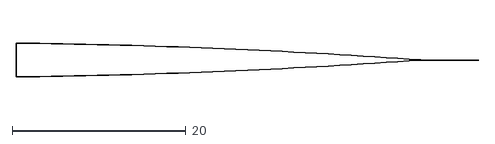
[picture p28: CAD file, 2026-11-10]
proposals/structure/wing_box_spar/rib_R3_rear.dxf
53.2 x 3.89
