lukewalker2010/mach1-rc-design/proposals/structure/wing_box_spar/rib_R5_front.dxf

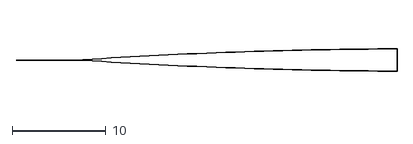
[picture p29: CAD file, 2026-11-10]
proposals/structure/wing_box_spar/rib_R5_front.dxf
40.6 x 2.36
