lukewalker2010/mach1-rc-design/(list of files, cad)

Other CAD files:
ab_flameholder.scad
ab_iris_nozzle.scad
ab_liner.scad
ab_spray_ring.scad
ab_transition.scad
