lukewalker2010/mach1-rc-design/fuselage_manufacturing/00_index.md

# Fuselage Manufacturing Package — Index

> **2026-09-16: NOT RELEASED FOR TOOLING.** The revised mould table closes to
> zero radius at station 850 mm. This index's older 200 mm bulkheads/stations
> are also inconsistent with the 185 mm re-baseline. Required matched-geometry
> closure: [25 R01/R16](../25_readiness_review.md); release process: [27](../27_manufacturing_release.md).

**Date:** 2026-07-21
**Purpose:** Close the manufacturing gap between design spec and build-ready data

## Files

| # | File | Contents |
|---|---|---|
| 01 | `01_mould_coordinates.md` | Fuselage profile coordinates, waist region detail, bulkhead flat patterns |
| 02 | `02_skin_layup.md` | Zone-by-zone layup schedule, mould procedure, hatch cutouts, engine mount |

## Key Manufacturing Data

- Split female mould (LH/RH halves at horizontal centreline)
- 7 skin zones with different thicknesses (0.6–1.2 mm)
- 8 bulkheads with detailed flat patterns
- CNC mould time: 12–16 hours per half
- Area-ruled waist: 200→178→200 mm cosine pinch
- Boat tail: 11.6° half-angle, 200→35 mm

## Bulkhead Summary

| BH# | Station (mm) | OD (mm) | Thickness | Function |
|-----|---|---|---|---|
| BH1 | 100 | 78 | 1.0 mm | Nose former |
| BH2 | 350 | 193 | 1.0 mm | Avionics bay |
| BH3 | 600 | 200 | 1.0 mm | Fuel tank fwd |
| BH4 | 850 | 200→178 | 1.2 mm | Waist ring / wing LE |
| BH5 | 1100 | 194 | 1.2 mm | Wing rear spar |
| BH6 | 1400 | 200 | 1.0 mm | Engine mount fwd |
| BH7 | 1600 | 200 | 1.0 mm | Engine mount aft |
| BH8 | 2050 | 97 | 1.0 mm | Tailcone former |
