lukewalker2010/mach1-rc-design/wing_manufacturing/01_rib_profiles.md

# Wing Rib Profile Coordinates — CNC/Cutting Data

> **Legacy coordinates — NOT FOR CUTTING (2026-09-16).** This sine/3.5% table
> differs from the current generator's parabolic/4% section. The newer DXFs also
> have verified hole breakouts; neither set is released. Resolve geometry and
> spar design together per [25 R02–R04](../25_readiness_review.md).

## Biconvex Airfoil Formula

```
y(x) = ±(t/2) × sin(π × x / c)
```

Where:
- x = chordwise position (0 = LE, c = TE)
- t = max thickness at that station = 0.035 × c
- c = local chord at that span station
- Upper surface: +y, Lower surface: −y

## Coordinate Convention

- Origin at LE of each rib
- x positive aft (toward TE)
- y positive upward
- All coordinates in **millimetres**
- 21 stations per surface (0% to 100% chord, 5% increments)

---

## Rib R0 — Root (Span = 0 mm, Chord = 211.0 mm)

Max thickness: 7.39 mm | Spar hole: 5.5 mm dia @ x = 63.3 mm

| i | x (mm) | y_upper (mm) | y_lower (mm) |
|---|---|---|---|
| 0 | 0.000 | 0.0000 | −0.0000 |
| 1 | 10.550 | 0.5776 | −0.5776 |
| 2 | 21.100 | 1.1410 | −1.1410 |
| 3 | 31.650 | 1.6764 | −1.6764 |
| 4 | 42.200 | 2.1704 | −2.1704 |
| 5 | 52.750 | 2.6110 | −2.6110 |
| 6 | 63.300 | 2.9873 | −2.9873 |
| 7 | 73.850 | 3.2900 | −3.2900 |
| 8 | 84.400 | 3.5118 | −3.5118 |
| 9 | 94.950 | 3.6470 | −3.6470 |
| 10 | 105.500 | 3.6925 | −3.6925 |
| 11 | 116.050 | 3.6470 | −3.6470 |
| 12 | 126.600 | 3.5118 | −3.5118 |
| 13 | 137.150 | 3.2900 | −3.2900 |
| 14 | 147.700 | 2.9873 | −2.9873 |
| 15 | 158.250 | 2.6110 | −2.6110 |
| 16 | 168.800 | 2.1704 | −2.1704 |
| 17 | 179.350 | 1.6764 | −1.6764 |
| 18 | 189.900 | 1.1410 | −1.1410 |
| 19 | 200.450 | 0.5776 | −0.5776 |
| 20 | 211.000 | 0.0000 | −0.0000 |

---

## Rib R1 — Span = 75 mm, Chord = 175.8 mm

Max thickness: 6.15 mm | Spar hole: 5.5 mm dia @ x = 52.7 mm

| i | x (mm) | y_upper (mm) | y_lower (mm) |
|---|---|---|---|
| 0 | 0.000 | 0.0000 | −0.0000 |
| 1 | 8.790 | 0.4813 | −0.4813 |
| 2 | 17.580 | 0.9507 | −0.9507 |
| 3 | 26.370 | 1.3967 | −1.3967 |
| 4 | 35.160 | 1.8083 | −1.8083 |
| 5 | 43.950 | 2.1754 | −2.1754 |
| 6 | 52.740 | 2.4889 | −2.4889 |
| 7 | 61.530 | 2.7412 | −2.7412 |
| 8 | 70.320 | 2.9259 | −2.9259 |
| 9 | 79.110 | 3.0386 | −3.0386 |
| 10 | 87.900 | 3.0765 | −3.0765 |
| 11 | 96.690 | 3.0386 | −3.0386 |
| 12 | 105.480 | 2.9259 | −2.9259 |
| 13 | 114.270 | 2.7412 | −2.7412 |
| 14 | 123.060 | 2.4889 | −2.4889 |
| 15 | 131.850 | 2.1754 | −2.1754 |
| 16 | 140.640 | 1.8083 | −1.8083 |
| 17 | 149.430 | 1.3967 | −1.3967 |
| 18 | 158.220 | 0.9507 | −0.9507 |
| 19 | 167.010 | 0.4813 | −0.4813 |
| 20 | 175.800 | 0.0000 | −0.0000 |

---

## Rib R2 — Span = 150 mm, Chord = 140.7 mm

Max thickness: 4.92 mm | Spar hole: 5.5 mm dia @ x = 42.2 mm

| i | x (mm) | y_upper (mm) | y_lower (mm) |
|---|---|---|---|
| 0 | 0.000 | 0.0000 | −0.0000 |
| 1 | 7.035 | 0.3852 | −0.3852 |
| 2 | 14.070 | 0.7609 | −0.7609 |
| 3 | 21.105 | 1.1178 | −1.1178 |
| 4 | 28.140 | 1.4473 | −1.4473 |
| 5 | 35.175 | 1.7411 | −1.7411 |
| 6 | 42.210 | 1.9920 | −1.9920 |
| 7 | 49.245 | 2.1939 | −2.1939 |
| 8 | 56.280 | 2.3417 | −2.3417 |
| 9 | 63.315 | 2.4319 | −2.4319 |
| 10 | 70.350 | 2.4623 | −2.4623 |
| 11 | 77.385 | 2.4319 | −2.4319 |
| 12 | 84.420 | 2.3417 | −2.3417 |
| 13 | 91.455 | 2.1939 | −2.1939 |
| 14 | 98.490 | 1.9920 | −1.9920 |
| 15 | 105.525 | 1.7411 | −1.7411 |
| 16 | 112.560 | 1.4473 | −1.4473 |
| 17 | 119.595 | 1.1178 | −1.1178 |
| 18 | 126.630 | 0.7609 | −0.7609 |
| 19 | 133.665 | 0.3852 | −0.3852 |
| 20 | 140.700 | 0.0000 | −0.0000 |

---

## Rib R3 — Span = 225 mm, Chord = 105.5 mm

Max thickness: 3.69 mm | Spar hole: 5.5 mm dia @ x = 31.6 mm

| i | x (mm) | y_upper (mm) | y_lower (mm) |
|---|---|---|---|
| 0 | 0.000 | 0.0000 | −0.0000 |
| 1 | 5.275 | 0.2888 | −0.2888 |
| 2 | 10.550 | 0.5705 | −0.5705 |
| 3 | 15.825 | 0.8382 | −0.8382 |
| 4 | 21.100 | 1.0852 | −1.0852 |
| 5 | 26.375 | 1.3055 | −1.3055 |
| 6 | 31.650 | 1.4936 | −1.4936 |
| 7 | 36.925 | 1.6450 | −1.6450 |
| 8 | 42.200 | 1.7559 | −1.7559 |
| 9 | 47.475 | 1.8235 | −1.8235 |
| 10 | 52.750 | 1.8463 | −1.8463 |
| 11 | 58.025 | 1.8235 | −1.8235 |
| 12 | 63.300 | 1.7559 | −1.7559 |
| 13 | 68.575 | 1.6450 | −1.6450 |
| 14 | 73.850 | 1.4936 | −1.4936 |
| 15 | 79.125 | 1.3055 | −1.3055 |
| 16 | 84.400 | 1.0852 | −1.0852 |
| 17 | 89.675 | 0.8382 | −0.8382 |
| 18 | 94.950 | 0.5705 | −0.5705 |
| 19 | 100.225 | 0.2888 | −0.2888 |
| 20 | 105.500 | 0.0000 | −0.0000 |

---

## Rib R4 — Span = 300 mm, Chord = 70.3 mm

Max thickness: 2.46 mm | Spar hole: 5.5 mm dia @ x = 21.1 mm

| i | x (mm) | y_upper (mm) | y_lower (mm) |
|---|---|---|---|
| 0 | 0.000 | 0.0000 | −0.0000 |
| 1 | 3.515 | 0.1925 | −0.1925 |
| 2 | 7.030 | 0.3802 | −0.3802 |
| 3 | 10.545 | 0.5585 | −0.5585 |
| 4 | 14.060 | 0.7231 | −0.7231 |
| 5 | 17.575 | 0.8699 | −0.8699 |
| 6 | 21.090 | 0.9953 | −0.9953 |
| 7 | 24.605 | 1.0962 | −1.0962 |
| 8 | 28.120 | 1.1700 | −1.1700 |
| 9 | 31.635 | 1.2151 | −1.2151 |
| 10 | 35.150 | 1.2303 | −1.2303 |
| 11 | 38.665 | 1.2151 | −1.2151 |
| 12 | 42.180 | 1.1700 | −1.1700 |
| 13 | 45.695 | 1.0962 | −1.0962 |
| 14 | 49.210 | 0.9953 | −0.9953 |
| 15 | 52.725 | 0.8699 | −0.8699 |
| 16 | 56.240 | 0.7231 | −0.7231 |
| 17 | 59.755 | 0.5585 | −0.5585 |
| 18 | 63.270 | 0.3802 | −0.3802 |
| 19 | 66.785 | 0.1925 | −0.1925 |
| 20 | 70.300 | 0.0000 | −0.0000 |

---

## Rib R5 — Span = 375 mm, Chord = 35.2 mm

Max thickness: 1.23 mm | Spar hole: 5.5 mm dia @ x = 10.6 mm

| i | x (mm) | y_upper (mm) | y_lower (mm) |
|---|---|---|---|
| 0 | 0.000 | 0.0000 | −0.0000 |
| 1 | 1.760 | 0.0964 | −0.0964 |
| 2 | 3.520 | 0.1904 | −0.1904 |
| 3 | 5.280 | 0.2797 | −0.2797 |
| 4 | 7.040 | 0.3621 | −0.3621 |
| 5 | 8.800 | 0.4356 | −0.4356 |
| 6 | 10.560 | 0.4984 | −0.4984 |
| 7 | 12.320 | 0.5489 | −0.5489 |
| 8 | 14.080 | 0.5859 | −0.5859 |
| 9 | 15.840 | 0.6084 | −0.6084 |
| 10 | 17.600 | 0.6160 | −0.6160 |
| 11 | 19.360 | 0.6084 | −0.6084 |
| 12 | 21.120 | 0.5859 | −0.5859 |
| 13 | 22.880 | 0.5489 | −0.5489 |
| 14 | 24.640 | 0.4984 | −0.4984 |
| 15 | 26.400 | 0.4356 | −0.4356 |
| 16 | 28.160 | 0.3621 | −0.3621 |
| 17 | 29.920 | 0.2797 | −0.2797 |
| 18 | 31.680 | 0.1904 | −0.1904 |
| 19 | 33.440 | 0.0964 | −0.0964 |
| 20 | 35.200 | 0.0000 | −0.0000 |

---

## Rib R6 — Tip (Span = 450 mm)

- Chord: 0.0 mm (sharp tip)
- No rib required — tip is a point

---

## Summary Table

| Rib | Span (mm) | Chord (mm) | Max t (mm) | Spar x (mm) | Foam core height (mm) |
|-----|---|---|---|---|---|
| R0 | 0 | 211.0 | 7.39 | 63.3 | 6.39 |
| R1 | 75 | 175.8 | 6.15 | 52.7 | 5.15 |
| R2 | 150 | 140.7 | 4.92 | 42.2 | 3.92 |
| R3 | 225 | 105.5 | 3.69 | 31.6 | 2.69 |
| R4 | 300 | 70.3 | 2.46 | 21.1 | 1.46 |
| R5 | 375 | 35.2 | 1.23 | 10.6 | 0.23 |

**Foam core height** = max thickness − 2 × 0.5 mm carbon web

---

## CNC Cutting Notes

### For Rib Foam Cores (CNC hot-wire or 3-axis mill)
- Material: ROHACELL 71 HF, 8 mm sheet
- Cut upper and lower profiles separately, bond together
- Spar hole: drill 5.5 mm after bonding, at 30% chord
- Tolerance: ±0.1 mm on profile, ±0.2 mm on spar hole position

### For Rib Carbon Webs (CNC router or laser cut)
- Material: 0.5 mm carbon-epoxy sheet (cured layup)
- Cut outer profile matching biconvex shape
- Spar hole: 5.5 mm, aligned with foam core
- 3 mm flange on each face for skin bonding

### For DXF Export
- Export each rib as a closed polyline (upper LE → TE → lower TE → LE)
- Coordinate system: x = chordwise (0 at LE), y = thickness (0 at midplane)
- File naming: `wing_rib_R{n}_profile.dxf`
