lukewalker2010/mach1-rc-design/wing_manufacturing/rib_coordinates_v2.csv

rib | span_y_mm | chord_mm | x_frac | upper_outer_y_mm | lower_outer_y_mm | upper_web_y_mm | lower_web_y_mm | spar_hole_dia_mm
R0 | 0.0 | 210.0 | 0.00 | 0.0000 | -0.0000 | 0.0000 | 0.0000 | 6.0
R0 | 0.0 | 210.0 | 0.05 | 0.7980 | -0.7980 | 0.2980 | -0.2980 | 6.0
R0 | 0.0 | 210.0 | 0.10 | 1.5120 | -1.5120 | 1.0120 | -1.0120 | 6.0
R0 | 0.0 | 210.0 | 0.15 | 2.1420 | -2.1420 | 1.6420 | -1.6420 | 6.0
R0 | 0.0 | 210.0 | 0.20 | 2.6880 | -2.6880 | 2.1880 | -2.1880 | 6.0
R0 | 0.0 | 210.0 | 0.25 | 3.1500 | -3.1500 | 2.6500 | -2.6500 | 6.0
R0 | 0.0 | 210.0 | 0.30 | 3.5280 | -3.5280 | 3.0280 | -3.0280 | 6.0
R0 | 0.0 | 210.0 | 0.35 | 3.8220 | -3.8220 | 3.3220 | -3.3220 | 6.0
R0 | 0.0 | 210.0 | 0.40 | 4.0320 | -4.0320 | 3.5320 | -3.5320 | 6.0
R0 | 0.0 | 210.0 | 0.45 | 4.1580 | -4.1580 | 3.6580 | -3.6580 | 6.0
R0 | 0.0 | 210.0 | 0.50 | 4.2000 | -4.2000 | 3.7000 | -3.7000 | 6.0
R0 | 0.0 | 210.0 | 0.55 | 4.1580 | -4.1580 | 3.6580 | -3.6580 | 6.0
R0 | 0.0 | 210.0 | 0.60 | 4.0320 | -4.0320 | 3.5320 | -3.5320 | 6.0
R0 | 0.0 | 210.0 | 0.65 | 3.8220 | -3.8220 | 3.3220 | -3.3220 | 6.0
R0 | 0.0 | 210.0 | 0.70 | 3.5280 | -3.5280 | 3.0280 | -3.0280 | 6.0
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
