lukewalker2010/mach1-rc-design/wing_manufacturing/rib_coordinates.csv

rib | span_mm | chord_mm | station | x_mm | y_upper_mm | y_lower_mm | spar_x_mm
R0 | 0 | 211.0 | 0 | 0.000 | 0.0000 | -0.0000 | 63.3
R0 | 0 | 211.0 | 1 | 10.550 | 0.5776 | -0.5776 | 63.3
R0 | 0 | 211.0 | 2 | 21.100 | 1.1410 | -1.1410 | 63.3
R0 | 0 | 211.0 | 3 | 31.650 | 1.6764 | -1.6764 | 63.3
R0 | 0 | 211.0 | 4 | 42.200 | 2.1704 | -2.1704 | 63.3
R0 | 0 | 211.0 | 5 | 52.750 | 2.6110 | -2.6110 | 63.3
R0 | 0 | 211.0 | 6 | 63.300 | 2.9873 | -2.9873 | 63.3
R0 | 0 | 211.0 | 7 | 73.850 | 3.2900 | -3.2900 | 63.3
R0 | 0 | 211.0 | 8 | 84.400 | 3.5118 | -3.5118 | 63.3
R0 | 0 | 211.0 | 9 | 94.950 | 3.6470 | -3.6470 | 63.3
R0 | 0 | 211.0 | 10 | 105.500 | 3.6925 | -3.6925 | 63.3
R0 | 0 | 211.0 | 11 | 116.050 | 3.6470 | -3.6470 | 63.3
R0 | 0 | 211.0 | 12 | 126.600 | 3.5118 | -3.5118 | 63.3
R0 | 0 | 211.0 | 13 | 137.150 | 3.2900 | -3.2900 | 63.3
R0 | 0 | 211.0 | 14 | 147.700 | 2.9873 | -2.9873 | 63.3
R0 | 0 | 211.0 | 15 | 158.250 | 2.6110 | -2.6110 | 63.3
R0 | 0 | 211.0 | 16 | 168.800 | 2.1704 | -2.1704 | 63.3
R0 | 0 | 211.0 | 17 | 179.350 | 1.6764 | -1.6764 | 63.3
R0 | 0 | 211.0 | 18 | 189.900 | 1.1410 | -1.1410 | 63.3
R0 | 0 | 211.0 | 19 | 200.450 | 0.5776 | -0.5776 | 63.3
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
