lukewalker2010/mach1-rc-design/records/test_card.md

# Test card — TEMPLATE (NOT RUN)

- Test ID / revision / date:
- Responsible test engineer / operator / reviewer:
- Purpose and requirement/finding IDs:
- Hardware part revisions and serials:
- Repository / firmware / configuration commits:
- Prerequisite releases and inspection evidence:
- Test article condition, fuel state, measured mass/CG (if applicable):
- Facility / fixture / operating conditions:

## Instrumentation

| Channel / quantity / units | Sensor serial | Calibration ID / validity | Range / uncertainty | Source sample rate / timestamp |
|---|---|---|---|---|
| | | | | |

## Procedure and limits

| Step | Command / condition | Acceptance criterion and source | Abort criterion / action | Recorded evidence |
|---|---|---|---|---|
| | | | | |

## Results (complete after test)

- Actual conditions and deviations:
- Raw data paths / SHA-256 per independent file:
- Data gaps / clock alignment / uncertainty assessment:
- Analysis command / version / output:
- Measured result versus each acceptance criterion:
- Post-test inspection and article disposition:
- Result: NOT RUN / FAIL / PASS (select with evidence):
- Reviewer / date:
- Next permitted test/configuration/envelope:
