lukewalker2010/mach1-rc-design/(commit log)

2026-07-13 Initial design package: P550-PRO Mach 1 RC aircraft
    Path 2 design: P550-PRO turbojet with C-D nozzle, Cd 0.166,
    level-flight Mach 1 at 10,000 ft. Complete airframe spec,
    C-D nozzle fab drawing, supersonic intake design, wing/fuselage
    structure, stabilator with tailerons, systems layout,
    launch/recovery systems, and BOM with build sequence.
    10 design documents, ~164KB total.
2026-07-21 Add wing manufacturing package: rib profiles, mould design, layup schedule
    - 01_rib_profiles.md: Biconvex airfoil coordinates for all 6 ribs (21 stations each)
    - 02_mould_design.md: CNC male plug geometry, machining sequence, vacuum bag setup
    - 03_layup_schedule.md: Ply-by-ply instructions, cure cycle, bond schedule, QA
    - rib_coordinates.csv: Machine-readable coordinates for CNC import
    - All generated from biconvex formula: y(x) = (t/2) * sin(pi*x/c), t/c=3.5%
    [rib_coordinates.csv]
2026-07-21 Add complete manufacturing packages for fuselage, stabilator, and DXF files
    Fuselage manufacturing:
    - 01_mould_coordinates.md: Nose/parallel/boat-tail profile coordinates, waist region detail
    - 02_skin_layup.md: 7-zone skin schedule, mould procedure, hatch cutouts, engine mount
    - 00_index.md: Package overview
    Stabilator manufacturing:
    - 01_manufacturing.md: Biconvex airfoil coordinates, mould design, layup, bearing installation
    DXF files (CNC-ready):
    - 6 wing rib profiles (R0-R5) from biconvex formula
    - 3 stabilator profiles (root, mid, tip) from parabolic formula
    - All files include spar hole and centreline annotations
    Total: 13 new files, complete manufacturing data for all major compon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
    [STA_MID.dxf, STA_ROOT.dxf, STA_TIP.dxf, wing_rib_R0.dxf, wing_rib_R1.dxf, wing_rib_R2.dxf, wing_rib_R3.dxf, wing_rib_R4.dxf]
2026-07-21 Add complete BOM with direct purchase links
    - All 10 major categories with verified vendor URLs
    - Amazon, McMaster-Carr, CubePilot, KST, JetCat, Xometry, etc.
    - Priority buy checklist (long-lead vs quick-buy items)
    - Budget summary: ~,666 total
    - Prices verified July 2026
2026-07-23 fix: BOM link audit — replace dead/broken/weak links
    - Replace dead eagletreetechnologies.com with ReadyMadeRC pitot kit link
    - Remove broken Tomahawk Aviation redirect (EU article gone)
    - Update acpsales.com → acpcomposites.com/carbon-prepregs (direct category)
    - Update dragonplate.com → dragonplate.com/carbon-fiber-rod (direct product)
    - Update West System links to consistent naming
    - Clean up vendor display names (Fibre Glast, ChutingStar, Tower Hobbies, etc.)
    - Add bom_link_check_report.md with full audit results
2026-07-27 Add afterburner package: 4 design docs + 6 OpenSCAD parts
    - 14_afterburner_mechanical.md: transition, spray ring, flame holder, liner, iris nozzle
    - 15_afterburner_fuel_ignition.md: pump, injector, spark, plumbing
    - 16_afterburner_electronics.md: Pico control, sensors, state machine, telemetry
    - 17_afterburner_thermal_integration.md: thermal analysis, cooling, test plan
    - 6 OpenSCAD files: ab_transition, ab_spray_ring, ab_flameholder, ab_liner, ab_iris_nozzle, ab_assembly
    - Updated 00_index.md to include afterburner section
    [ab_assembly.scad, ab_flameholder.scad, ab_iris_nozzle.scad, ab_liner.scad, ab_spray_ring.scad, ab_transition.scad]
2026-07-27 Add CadQuery STEP generators and STEP files for all 5 afterburner parts
    - ab_transition_step.py → ab_transition.step
    - ab_spray_ring_step.py → ab_spray_ring.step
    - ab_flameholder_step.py → ab_flameholder.step
    - ab_liner_step.py → ab_liner.step
    - ab_iris_nozzle_step.py → ab_iris_nozzle.step
    - Python scripts are parametric; run with: python3 <script>.py
    - Updated 00_index.md
    [ab_flameholder.step, ab_iris_nozzle.step, ab_liner.step, ab_spray_ring.step, ab_transition.step]
2026-07-27 Add ab_assembly.step — full afterburner assembly (all 5 parts positioned correctly)
    Generated from ab_assembly_step.py. Stack: transition(0-103) +
    spray ring(103-115) + flame holder(115-150) + liner(150-350) +
    iris nozzle(350-385). For OnShape import.
    [ab_assembly.step]
2026-07-27 Fix all afterburner CAD: mounting features, V-gutter, proper Z-stack
    - Transition duct: body length 94mm (total 100mm for stack), bolt holes on both flanges
    - Spray ring: added 3mm mounting ring (100mm OD) for sandwich mounting between flanges
    - Flame holder: 4x M4 bolt holes in flange, proper V-gutter ring, glow plug boss, 6 radial arms
    - Liner: concentric inner liner + outer shell (no changes needed)
    - Iris nozzle: 4x M4 bolt holes + 6x pivot holes in mount ring, 6 petals with pins, sync ring with slots
    - Assembly: all 5 parts positioned at correct Z coordinates (0, 100, 115, 150, 350mm)
    with no gaps—matches design stack diagram
    [ab_assembly.step, ab_flameholder.step, ab_iris_nozzle.step, ab_liner.step, ab_spray_ring.step, ab_transition.step]
2026-07-27 Fix all afterburner CAD: correct Z-extents, no gaps, mounting features
    Transition: body 94mm + flanges 3+3 = 100mm total, 4x M3 inlet / 4x M4 outlet bolt holes
    Spray Ring: 15mm body with toroidal gallery, 6x injectors at 15° downstream, 4x M4 bolt holes, radial fuel tube
    Flame Holder: 3mm flange + 32mm body = 35mm total, 4x M4 bolt holes, V-gutter ring, 6 radial arms, glow plug
    Liner: 200mm, concentric inner (Inconel) + outer (304SS) tubes
    Iris: 3mm ring + 30mm petals + 2mm sync ring = 35mm total, 4x M4 + 6x pivot holes, trapezoidal petals
    Assembly: auto-positions each part by bounding box to eliminate gaps
    Stack: 0-100-115-150-350-385mm, no floating parts
    [ab_assembly.step, ab_flameholder.step, ab_iris_nozzle.step, ab_liner.step, ab_spray_ring.step, ab_transition.step]
2026-08-07 Re-baseline program for level Mach 1: single P550+afterburner closure, coordination infra
    - 18_program_requirements.md: authoritative re-baseline — mission rules, thrust/drag closure (wet 450-475 N vs hump drag <=430 N), corrected geometry (185mm x 2.6m fuse, consistent wing planform, box spar, viable stabilator), CG solution (0.975 m, 1.0 kg ballast), M&V instrumentation, flight test plan, 24 audit dispositions
    - AGENTS.md + INTERFACES.md: coordination contract for 5-engineer + AI team (baselines, quality gates, 12 interface control records)
    - 00_index.md: re-baselined key parameters
    - CAD verified: all afterburner STEPs import clean, correct bboxes, zero assembly interferences, regenerat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
2026-08-07 E2: afterburner bench program v2 + AB docs at corrected mdot=1.10 kg/s
    - 21_afterburner_bench_program.md: build-ready bench qualification (wet thrust
    >=450 N gate), all numbers from tools/ab_bench_analysis.py
    - 14/17 corrected to mdot=1.10 (not 0.69) per 18 sec 2.1
    - tools/ab_bench_analysis.py: wet-thrust, fuel-flow, O2-balance, thermal model
2026-08-07 E3: BOM v2 + systems/M&V at corrected mass table
    - 22_bom_v2.md: 107-line BOM, total $9,662, single-source flags (22)
    - 23_systems_mv.md: TAT/loggers/FPV gap closure, fuel vent resized, Cube+
    power chain, M&V chain per 18 sec 5
    - tools/bom_v2_check.py: line-item re-sum, cost groups, MTOW/CG check
2026-08-07 E1: aero/structural closure on re-baselined geometry (D4)
    - 19_aero_evaluation_v2.md: hump drag 338 N <= 430 contract (PASS), sustain
    M1.10 385 N < 451 wet; stability PASS at both fuel loads with tail-incl NP
    (full +75%, empty +29% MAC) - resolves E3 empty-fuel finding
    - 20_structural_analysis_v2.md: box spar 5x0.2mm T300 x50mm @ 7mm sep ->
    cap m=2.6, web m=2.8 at 6g; engine mount and thermal margins verified
    - tools/aero_evaluation.py + tools/structural_analysis.py: committed analysis
    - P0 follow-ups: pitch authority at rotation (high SM), 18 sec 3.2 spar
    change-notice
2026-08-07 E5: regenerate net-part DXF + mould tables from corrected geometry (D3/D14/D22)
    - wing_manufacturing/gen_wing_ribs.py + rib_coordinates_v2.csv + 9 DXFs:
    only LWPOLYLINE, biconvex 4% t/c, chord 210->84 mm, web offset 0.5 mm,
    spar hole 6 mm @ 30% chord; stabilator 6% t/c, spar hole 2.5 mm
    - fuselage_manufacturing/01_mould_coordinates.md: body law R(x) re-derived
    (R(425)=92.5, R(850)=0, R(1050)=86, R(1390-1800)=92.5, R(2600)=55)
    - stabilator_manufacturing/01_manufacturing.md: t(z) fixed, 6% t/c
    [STA_MID.dxf, STA_ROOT.dxf, STA_TIP.dxf, rib_coordinates_v2.csv, wing_rib_R0.dxf, wing_rib_R1.dxf, wing_rib_R2.dxf, wing_rib_R3.dxf]
2026-08-07 E2: add AB thrust-stand design + structural check tool (24)
2026-09-16 Add readiness audit, corrected analyses, and measurement checks
    Correct half-wing equilibrium, fuel-state CG reporting, power conversion, and unsupported qualification claims. Add artifact screening, shock-aware air data, uncertainty-aware log screening, manufacturing records, and 21 regression tests with CI. Document unresolved geometry, hardware, and flight-validation work without changing controlled mating dimensions.
    [build_traveller.csv, part_release.csv, test_results.csv]
2026-09-17 Add delegated workstream analysis, cross-workstream review, and closure tracker (R01–R16)
    Implemented seven parallel analysis workstreams covering all readiness-review
    findings, with targeted technical review and principal integration:
    - 28_closure_tracker.md: full item-by-item status, corrections, remaining
    decisions and provenance (reviews/agent_provenance.json)
    - 29–35: deliverable docs for geometry, structure/recovery, mass/CG,
    propulsion/thermal, instrumentation/power, bench software, rig/manufacturing
    - 16 new analysis tools and 11 new test files with 179 passing tests
    - Cross-workstream consistency tests (test_workstream_consistency.py)
    - CI updated to archive manufacturing-r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
    [illustrative_mission.csv]
2026-11-08 Repair afterburner CAD: single-solid parts and assembly, STEP gate
    Fixes found by STEP import inspection (see 36):
    - flame holder: self-intersecting V-gutter profile produced a zero-volume
    sliver and detached glow-plug boss; rebuilt as outer-V minus inner-V,
    with housing walls to the full 35 mm section
    - iris: petals were at 2x throat radius (outside the 100 mm ring); 12 mm
    slots severed the 7.5 mm sync ring into six arcs; pivot pins were on the
    axis. Petals now span throat to ring OD, pins pass through the ring,
    slots are 5 x 2.4 mm, stops overlap the ring
    - liner: inner liner and shell were unattached; added the three spacer
    ribs and made the cooling inlet and film holes radial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
2026-11-08 AB cooling at corrected flow; reconcile iris; enforce STEP gate in CI
    - tools/ab_cooling.py: choked 1 mm hole = 0.247 g/s; at the corrected
    1.10 kg/s core flow the 2.3-3.0% bleed needs 102-134 holes, not the
    legacy 65/20. Chosen schedule 112 holes in 5 rows = 2.51%.
    - ab_liner_step.py: generates the 112 staggered, radial, 30-degree
    downstream holes from that schedule (single solid preserved).
    - iris: petal_len 30->29 and sync_ring_t 2->3 mm so the section is
    3+29+3=35 mm; doc 14 parameters/code and 36 caveats aligned.
    - 17: erratum that its 0.69 kg/s thermal numbers are superseded by 1.10.
    - CI: new cad-geometry job installs cadquery-ocp only and runs
    tools/step_validate.py, so the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
2026-11-08 R05 decision input: coupled fuel-station CG closure candidates
    Adds tools/cg_candidates.py + tests and proposals/mass/cg_closure_candidates.md.
    Finding: with dry CG pinned at the 0.995 m limit, the full-fuel constraint
    requires a fuel centroid of at least 0.6592 m at 13.60 kg. Three constructive
    candidates then close both endpoints:
    A fuel 0.66 m + 1.68 kg nose ballast 14.28 kg, CG 0.957/0.995
    B fuel 0.66 m + engine 1.076 m 13.60 kg, CG 0.955/0.995
    A-margin fuel 0.81 m + 1.82 kg nose ballast 14.42 kg, CG 0.965/0.985
    A and B sit exactly on the acceptance boundary and are not robust to the
    doc 31 uncertainty; packaging of the aft fuel bay remains unresolved. N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
2026-11-08 Update closure tracker and AGENTS status with 2026-11-08 progress
    Records the three advances without closing any R01-R16 finding:
    AB CAD import-validated + CI gate (36), R08 cooling schedule at 1.10 kg/s,
    and the R05 fuel-station CG candidates. Statuses remain in progress; no
    physical evidence was added.
2026-11-08 R01 decision input: continuous fuselage body-law candidate
    The released mould law R=0.0925*sin(pi*x/0.85) reaches R=0 at x=850 mm and
    pinches the fuselage shut. Adds tools/fuselage_profile.py implementing the
    29 knot set with smoothstep joins, a 53-station table
    (proposals/geometry/fuselage_stations_v3.csv), tests, and a proposal note.
    Result: max radius 92.5 mm, min interior radius 0.92 mm, zero knot slope.
    Does not close R01: the 103 mm intake throat still cannot fit this nose
    (29), and the controlled mould table is unchanged.
    Verification: 194 unit tests OK.
2026-11-10 R02/R04: fit-first closed box spar and contained net ribs
    Replaces the impossible 30%-chord/50 mm cap concept with a 50%-chord
    closed box at maximum thickness. Cap width is iterated from local moment
    and actual cap-centroid separation, with tapered 1.0->0.4 mm caps and two
    1 mm box-side shear walls. Front/rear rib segments sit outside the box,
    eliminating the failed round spar holes.
    - tools/wing_box_spar.py sizes all seven stations under the 9g/150 N.m
    screen and generates stations.csv plus 14 front/rear rib DXFs
    - every station has positive cap separation and box height; all rib
    vertices are contained in the airfoil contour
    - doc 37 records the construction, schedule and remaining qua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
2026-11-13 Refresh repository status and correct stale legacy claims
    - Record 2026-11-13 verification: 199 tests pass, CI green, links resolve
    - Mark 01 as superseded instead of 'Design Complete'
    - Mark legacy BOM 09/09-links historical and point to current 22
    - Scope the 2026-07-23 link report to the legacy BOM
    - Note docs 36/37 in AGENTS status board
